taku0625/try_astra_cad/README.md

# FreeCAD：背面ねじ固定式 C2 / MID-360 一体型PLA治具

カメラは台座に載せて**背面4穴で固定**します。カメラの上面・側面を囲う保持枠はありません。背面板には固定ねじ穴とケーブル用の開口を設け、補強は背面側だけに置いています。FreeCADで編集できる、**PLA造形部品1個**の設計です。

カメラは上・前向き、MID-360は下・下向き、両ケーブル口は後方を維持しています。カメラ位置は前版のX=30 mmから**X=22 mmへ8 mm後退**させました。

上下のご指摘を反映し、カメラを**光軸（+X）まわりに180°回転**しました。背面コネクタがレンズ中心より下になる姿勢です。元STEPの+Z方向を組立の−Z方向に向け、元Z=+22.5 mmの面を台座に載せています。

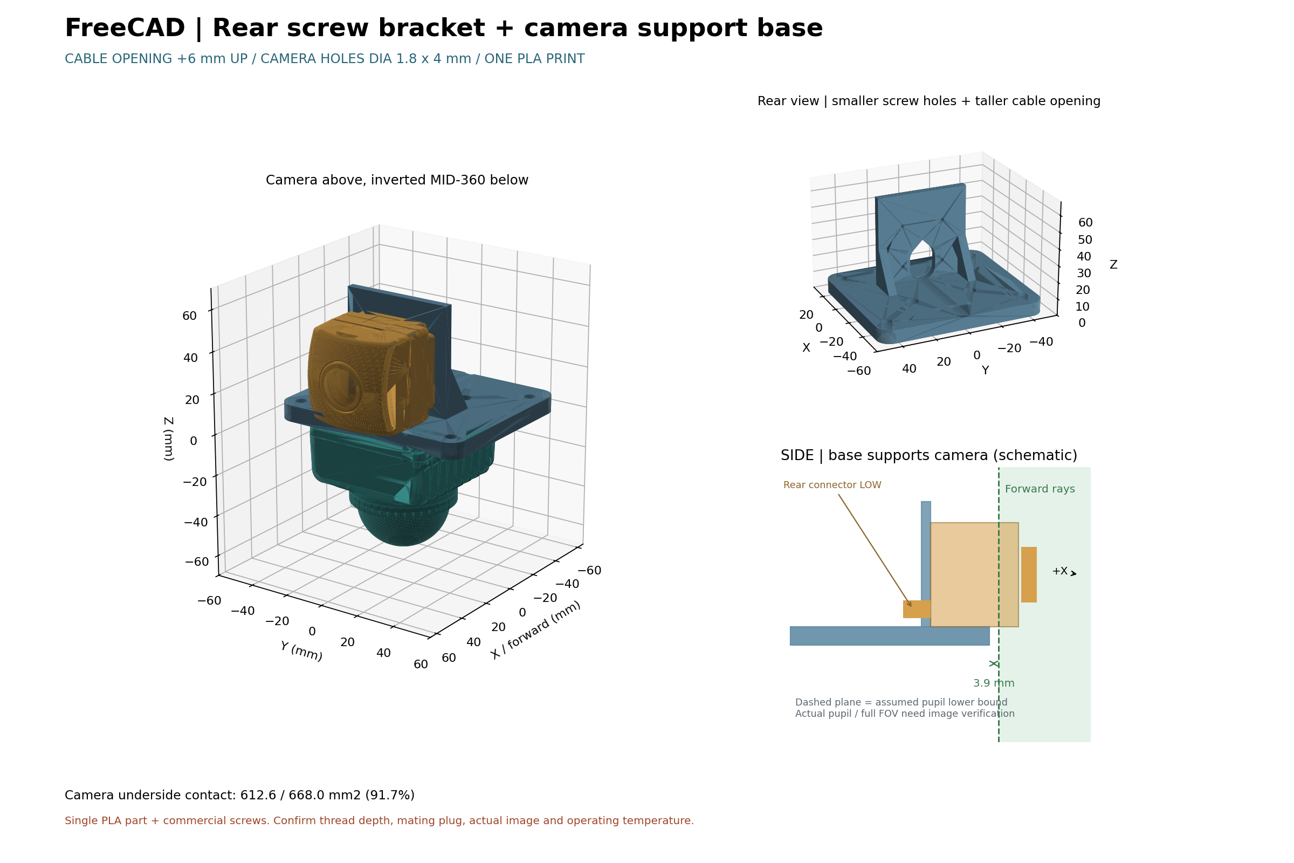
[picture p1: output/assembly_preview.png]
組立・背面ブラケット・視野確認図


## 使用するファイル

- **`output/fixture.FCStd`**：FreeCADの編集用ドキュメント。寸法表、標準フィーチャー、実センサー参照形状を含みます。
- **`output/fixture.stl`**：印刷する部品1個だけのSTL。単位mm。
- `output/fixture.step`：治具だけのSTEP。
- `output/assembly.step`：両センサーを含む確認用STEP。これはプリントしません。
- `output/review_drawing.pdf`：組立図、背面穴・台座穴の座標、寸法、造形・組立手順。
- `output/validation.json`：穴位置・干渉・台座支持面・STL・FreeCAD再編集の検証結果。
- `fixture_cad.zip`：これらと生成コード、元のセンサーSTEPをまとめた一式。

## 背面の取付穴とケーブル開口

添付カメラSTEPの背面（元座標Y=-16.4 mm）にある4個の穴を調べ、元座標X/Z=±12.5、**25 × 25 mmピッチ**を確認しました。使用ねじはユーザー確認済みの**M1.6・頭下約8 mm**です。STEPの穴入口形状は直径約2.57 mmですが、この外形値からねじ径は決まりません。中心軸上では入口から7 mmの位置にソリッドが現れますが、これも許容ねじ込み深さの保証ではありません。

カメラ固定穴が大きく深いという実機でのご指摘に合わせ、治具の穴径を**φ3.6 → φ1.8 mm**、背面板の厚さ（穴の通し長さ）を**6 → 4 mm**に変更しました。背面板の幅は55 mm、台座上面からの高さは54 mmです。指定の**M1.6・頭下約8 mmのねじなら、ワッシャーなしでカメラ側への挿入が約4 mm**となります。ねじ頭は板の後ろに当てる構造です。実機の許容挿入深さに合わせて使用してください。φ1.8 mmの小径横穴はPLA印刷で狭くなることがあるため、印刷後にバリを取り、必要に応じて1.8 mmドリル等で通りを整えてください。

ケーブル挿入時に上側が引っかかるというご指摘に合わせ、開口を**上側へ6 mm延長**しました。φ16 mmの円を上方へ6 mm移動させた縦長の開口に、45°の屋根を付けた形です。最大幅16 mmと下端の位置を保ち、開口の頂点をZ=26.81 → 32.81 mmに上げています。上端を斜めにすることで、PLA印刷時に大きな水平の橋を作らない形にしています。相手プラグの実寸は未提供なので、この拡張量で実際に挿入できるか確認してください。

コネクタ軸はY=0、**Z=15.5 mm（台座上面から7.5 mm）**です。開口の下端が台座上面より0.5 mm低くなるため、後端まで深さ最大0.5 mmの浅い逃げを設けています。後方からの挿入経路は、φ16の円を上方へ6 mm延長した包絡形状で干渉を確認しています。背面4穴はY=±12.5、Z=18 / 43 mmで、各穴の周囲に想定φ3.0 mmのねじ頭が当たる面を確保しています。実ねじ頭の寸法は別途確認してください。

参照指定：[Switch Science 商品8509](https://www.switch-science.com/products/8509)。本環境では商品ページがネットワーク制限で取得できませんでした。この治具は、ユーザーの「背面ねじ固定・ケーブル穴」という指定と添付STEPの実形状に基づいています。商品図面の寸法を転用したものではありません。

## 台座での支持と視野対策

+Xがカメラ前方、+Zが上です。カメラの下面は台座上面Z=8 mm、下向きLiDARの取付面は台座下面Z=0 mmです。

- 台座：86 × 100 × 8 mm、XY中心=(-12, 0)、角R8。前端X=31 mm。
- カメラ基準位置：X=22、Y=0。背面の接触面はX=5.6 mm。
- LiDAR基準位置：X=0、Y=0。取付ピッチ48 × 36 mm。
- 背面板の後ろに、幅5・奥行16・高さ26 mmの三角補強2個を一体化。
- 造形全体：86 × 100 × 62 mm。

カメラ下面の平らな面は合計668.0 mm²あり、そのうち約612.6 mm²（約91.7%）が台座に接触します。LiDAR固定穴の開口などを除いた支持面です。カメラの重さは台座で受け、背面ねじで位置と姿勢を固定します。

カメラを8 mm戻すと同時に、台座の前端を前版から4 mm短くしました。治具の最前部X=31 mmに対し、レンズ筒の付け根から取った基準面はX=34.9 mmです。**治具全体は、この面より3.9 mm後方にあります。**

視野検証は「入射瞳がこの基準面以降にある」「視野が前方半球に収まる」という従来と同じ条件です。176°は水平視野の仮定値として記載しています。正確な入射瞳位置、鉛直・対角視野、校正情報はSTEPに含まれません。**実機の全画角画像で治具の映り込みがないことを最終確認してください。**

## 組立順序

1. 印刷後、穴と接触面のバリを取り、底面・背面の当たりを確認します。
2. MID-360を台座下面に下向きで取り付けます。カメラを載せる前なら、4本とも上から工具が入ります。LiDAR用はφ3.6通し穴、上面座ぐりφ6.8 × 深さ3.5 mmです。M3×8は挿入3.5 mmとなる選定案です。
3. カメラは**背面コネクタが下側**になる向きで台座に載せ、前方から後ろへ移動して、後部コネクタをケーブル開口に通し、背面をブラケットに当てます。
4. 後方（−X）からM1.6・頭下約8 mmのねじ4本でカメラを固定します。治具はφ1.8 mmの通し穴です。背面板4 mm＋カメラ挿入約4 mmの構成で、背面側の補強はねじ頭と工具の経路を避けています。
5. ケーブルを接続し、設置先に固定します。設置先用はXY=(-43, ±42)、(23, ±42)のφ5.7穴4個です。下向きLiDARとケーブルを避ける支持構造が必要です。

ねじは市販品です。プリントする追加の押さえ板やナット保持部品はありません。実機のねじ規格・挿入深さ・締付トルクはメーカー情報に従ってください。

## PLA造形条件（開始値）

| 項目 | 設定案 |
|---|---|
| ノズル | 0.4 mm |
| 積層ピッチ | 0.2 mm |
| 外周 | 5周 |
| 上下面 | 各6層 |
| インフィル | 40%、Gyroid |
| 向き | 台座下面Z=0をベッドに置く |
| ブリム | 5 mm |
| サポート | まずOFFでスライサー確認。ケーブル穴上部は45°、横穴は小径 |

保持枠の天井を廃止し、ケーブル開口を涙滴形状にしています。小径横穴の上端などが正常に造形されるか、使用プリンタのスライサーで確認してください。温度・速度・冷却はPLAとプリンタのプロファイルに合わせてください。機種が未指定のためG-codeは付属しません。

PLAの通電時温度・長時間荷重による変形、振動時の保持を実機で確認してください。構造解析・耐久試験は未実施の試作設計です。

## FreeCADでの編集と再生成

`fixture.FCStd`をFreeCAD 1.0以降で開き、`Parameters`寸法表を編集します。標準プリミティブ・ブーリアン・式参照だけで再計算でき、外部Pythonモジュールは不要です。

- `CameraX`：カメラと背面板の前後位置（22 mm）。
- `BackT` / `BackW` / `BackH`：背面板厚（4 mm）・幅・台座上からの高さ。
- `CameraHoleD`：カメラ固定穴径（1.8 mm）。
- `MountPitch`：カメラ背面の穴ピッチ（25 mm）。
- `CableD` / `CableZ`：ケーブル開口径（16 mm）と台座上からの高さ（7.5 mm）。初期高さはカメラの回転と元STEPのコネクタ位置から算出。
- `CableUp`：ケーブル開口の上方延長量（6 mm）。
- `BraceW` / `BraceD` / `BraceH`：背面補強の寸法。
- `BaseL` / `BaseW` / `BaseT` / `BaseCX`：台座の寸法と前後位置。

最終造形形状は`PrintableFixture`です。STLを出力するときはこの部品だけを選択してください。参照センサーはスペースキーで表示を切り替えられます。穴位置や視野余裕も併せて確認してください。FCStd上の編集はJSONに自動反映されません。

この環境では、FreeCADモジュールがある`/usr/bin/python3`で形状を生成し、Matplotlibで確認図を作ります。CadQueryは使用していません。

```bash
cd /workspace/try_astra_cad
python -m pip install -r requirements.txt
python cad/build.py
```

形状コードは`cad/freecad_build.py`、寸法は`cad/parameters.json`です。別環境では`FREECAD_PYTHON`でFreeCADモジュールを読めるPythonを指定できます。図面だけの更新は`python cad/build.py --render-only`です。

生成時には、カメラの180°回転・下側コネクタ、元STEPの背面穴抽出・取付穴一致、頭下8 mmねじの経路・ねじ頭の当たり面、工具の経路、上方延長したプラグ包絡形状の後方経路、センサーとの干渉、8段階の組立移動位置、実形状の台座支持面、視野基準面との余裕、STLの単一閉ソリッドを確認します。FCStdの再読込・背面板厚+1 mmの再計算・復元、STEP再読込も検証します。既存の隔離済みチェックアウトを使い、追加のGit worktreeは不要です。
