taku0625/try_astra_cad/output/assembly.step

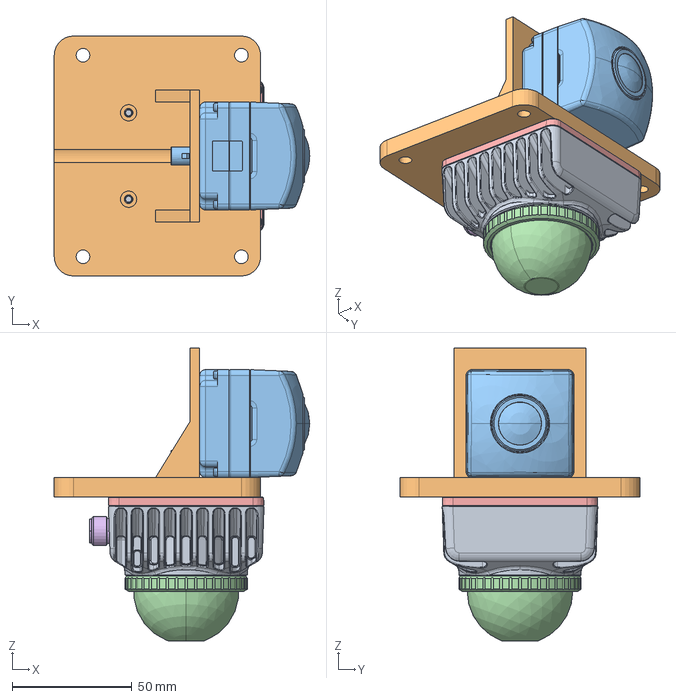
[picture p4: CAD file, 2026-10-27]
output/assembly.step
106.5 x 100.0 x 122.1 mm
