taku0625/try_astra_cad/cad/reference/c2_176.step

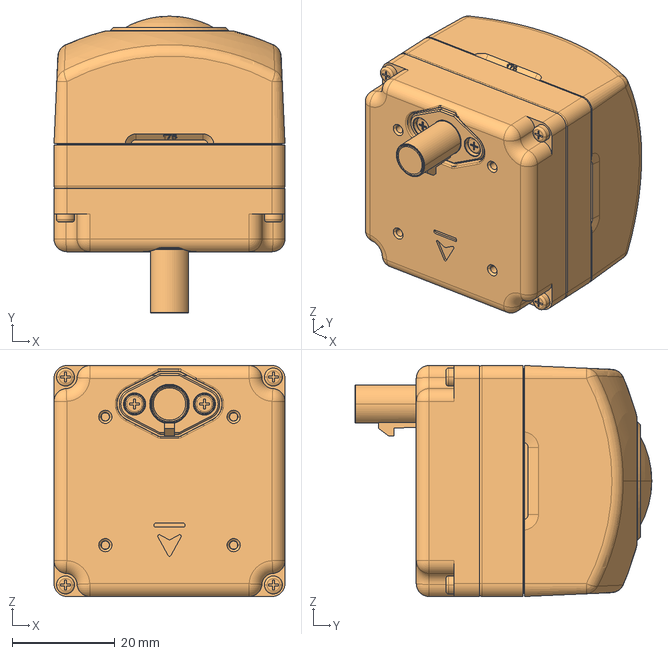
[picture p5: CAD file, 2026-10-26]
cad/reference/c2_176.step
45.0 x 57.8 x 45.0 mm
