taku0625/try_astra_cad/cad/reference/mid360.step

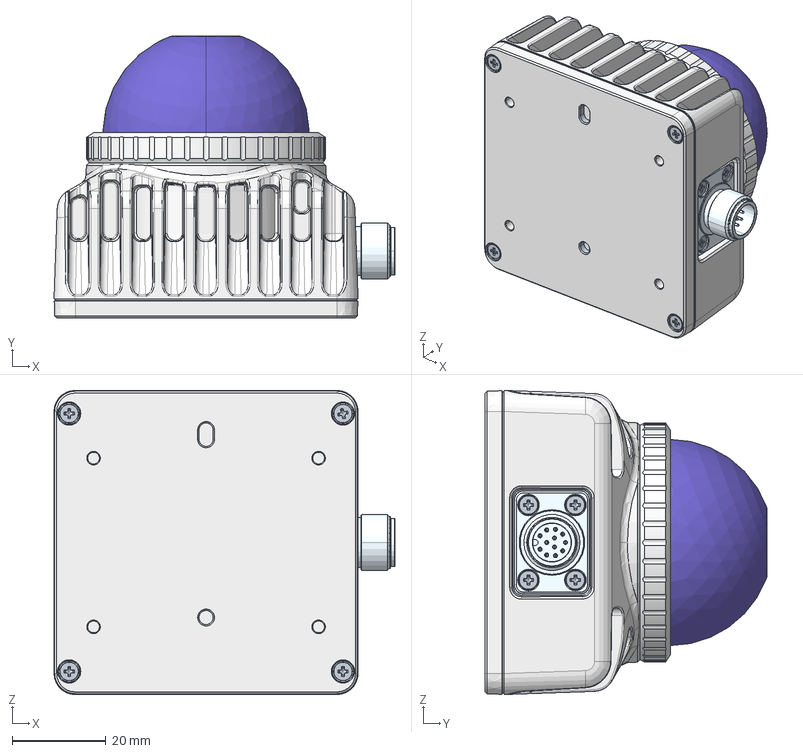
[picture p6: CAD file, 2026-10-26]
cad/reference/mid360.step
72.7 x 60.1 x 64.9 mm
MID-360_4_1
MID-360_4_2
MID-360_4_3
MID-360_4_4
MID-360_4_5
MID-360_4_6
MID-360_4_7
