taku0625/try_astra_cad/output/fixture.step

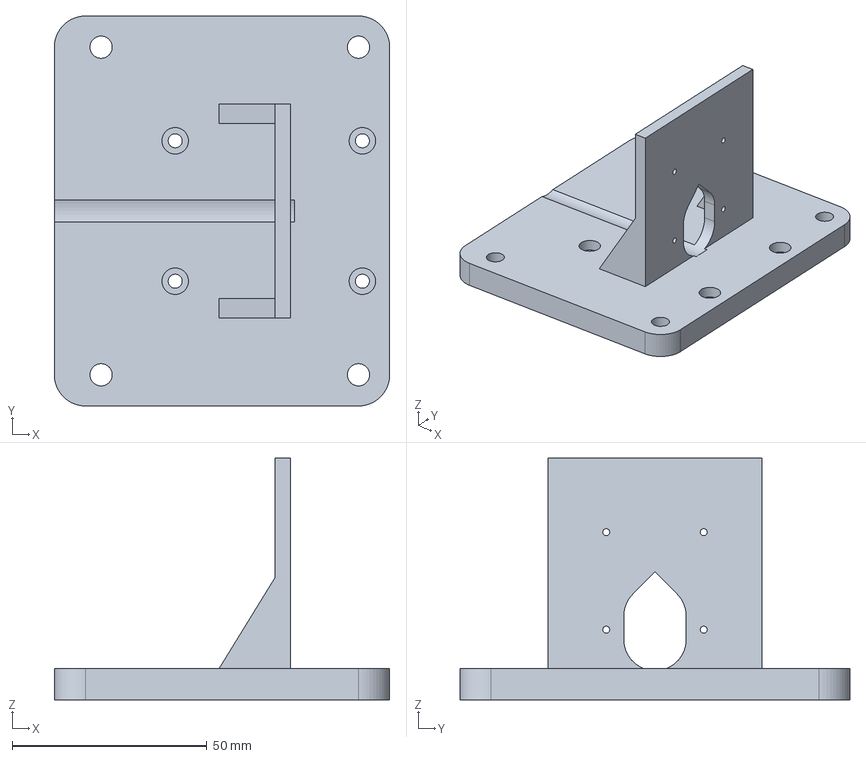
[picture p7: CAD file, 2026-10-27]
output/fixture.step
86.0 x 100.0 x 62.0 mm
