taku0625/try_astra_cad/(list of files, cad)

Other CAD files:
output/fixture.FCStd
output/fixture.stl
