taku0625/try_astra_cad/(commit log)

2026-10-26 Add coplanar mounting fixture for TIER4 C2 and Livox MID-360
    [assembly.step, bom.csv, c2_176.step, cap.dxf, cap.step, cap.stl, mid360.step, plate.dxf]
2026-10-26 Stack camera above inverted MID-360 with rear-facing cable ports
    [assembly.step, bom.csv, cap.dxf, cap.step, cap.stl, plate.dxf, plate.step, plate.stl]
2026-10-26 Rebuild mount in FreeCAD as a single PLA print with forward camera clearance
    [assembly.step, bom.csv, cap.dxf, cap.step, cap.stl, fixture.FCStd, fixture.step, fixture.stl]
2026-10-26 Use rear camera screw bracket with supported base and reduced forward offset
    [assembly.step, bom.csv, fixture.FCStd, fixture.step, fixture.stl]
2026-10-26 Correct camera roll and lower rear cable clearance
    [assembly.step, fixture.FCStd, fixture.step, fixture.stl]
2026-10-27 Enlarge upper cable clearance and fit M1.6x8 camera screws
    [assembly.step, bom.csv, fixture.FCStd, fixture.step, fixture.stl]
